balena-io/autohat-board/hardware/main-board/fabrication-files/BOM.xls

 | Bill of Materials (BOM)
Item # | Ref Des | Qty | Manufacturer | Mfg Part # | Description | Package | Type | Your Instructions
1 | U7,U4 | 2 | Texas Instruments | SN74AHC1G14DBVR | IC SCHMITT-TRG INV GATE SOT23-5 | SOT-23-5 | SMD
2 | C25,C5,C24,C26,C1,C7,C10,C11,C13,C14,C15,C16,C17,C18,C20,C22,C6 | 17 | Kemet | C0805C104K5RACTU | CAP CER 0.1UF 50V X7R 0805 | 0805 | SMD
3 | R17,R10,R14,R15,R18,R19,R3,R4,R25,R26 | 10 | Yageo | RC0805JR-0710KL | RES SMD 10K OHM 5% 1/8W 0805 | 0805 | SMD
4 | Q7,Q3,Q4,Q8,Q1,Q2 | 6 | Infineon Technologies | IRF7606TRPBF | MOSFET P-CH 30V 3.6A MICRO8 | Micro8 | SMD
5 | U1 | 1 | Texas Instruments | TS3USB30EDGSR | IC USB SWITCH SGL 1X2 10MSOP | 10-VSSOP | SMD
6 | U8 | 1 | Texas Instruments | TS3A27518EPWR | IC MUX/DEMUX HEX 1X2 24TSSOP | 24-TSSOP | SMD
7 | C2,C21,C23 | 3 | Murata | GRM219R61E106KA12D | CAP CER 10UF 25V X5R 0805 | 0805 | SMD
8 | C8,C9,C28,C29 | 4 | Johanson | 500R15N270KV4T | CAP CER 27PF 50V NP0 0805 | 0805 | SMD
9 | C27 | 1 | Murata | GRM21BR61E475KA12L | CAP CER 4.7UF 25V X5R 0805 | 0805 | SMD
10 | D1,D4 | 2 | Micro Commercial Co | ES1A-LTP | DIODE GEN PURP 50V 1A DO214AC | DO-214AC (SMA) | SMD
11 | FB1 | 1 | Laird-Signal Integrity Products | MI0805K400R-10 | FERRITE BEAD 40 OHM 0805 1LN | 0805 | SMD
12 | R2 | 1 | Vishay Dale | CRCW080590K9FKEA | RES SMD 90.9K OHM 1% 1/8W 0805 | 0805 | SMD
13 | R11,R12,R16,R20,R5,R6,R7,R9 | 8 | Vishay Dale | CRCW08054K70FKEA | RES SMD 4.7K OHM 1% 1/8W 0805 | 0805 | SMD
14 | RL1 | 1 | Omron | G2R-2-DC5 | RELAY GENERAL PURPOSE DPDT 5A 5V | 8POS | thru-hole
15 | U2 | 1 | FTDI | FT245RL-REEL | IC USB TO PARALLEL FIFO 28-SSOP | 28-SSOP | SMD
16 | Q5,Q6 | 2 | Fairchild Semiconductor | 2N7002 | MOSFET N-CH 60V 115MA SOT-23 | SOT-23 (TO-236AB) | SMD
17 | J1 | 1 | Hirose | DM3AT-SF-PEJM5 | CONN MICRO SD CARD PUSH-PUSH R/A | SMD | SMD
18 | P2,P3,P9 | 3 | Wurth Electronics Inc | 614004160211 | CONN USB | 4POS | thru-hole
19 | P6,P7 | 2 | Molex | 70246-0801 | CONN HEADER 8POS .100 VERT GOLD | 8POS | thru-hole
20 | P5,P10 | 2 | CUI Inc. | PJ-002AH | CONN PWR JACK 2.1X5.5MM HIGH CUR | 3POS | thru-hole | Oval drill holes
21 | P8,P1 | 2 | Hirose Connector | ZX62D-B-5P8(30) | CONN RCPT USB MICRO B SMD | SMD | SMD | Oval drill holes
22 | C3 | 1 | Murata | GRM2165C1H102FA01D | CAP CER 1000PF 50V NP0 0805 | 0805 | SMD
23 | C4 | 1 | Murata | GRM216R61E105KA12D | CAP CER 1UF 25V X5R 0805 | 0805 | SMD
24 | C12,C19 | 2 | Kemet | C0805C180J3GACTU | CAP CER 18PF 25V NP0 0805 | 0805 | SMD
25 | FB2,FB3 | 2 | Murata | BLM18PG221SN1D | FERRITE BEAD 220 OHM 0603 1LN | 0603 | SMD
26 | Y1 | 1 | Abracon LLC | ABLS-24.000MHZ-B2-T | CRYSTAL 24.0000MHZ 18PF SMD | HC49/US | SMD
27 | P4 | 1 | Wurth Electronics Inc | 61300611121 | CONN HEADER 6 POS 2.54 | 6POS | thru-hole
28 | R1,R13 | 2 | Vishay Dale | CRCW08051M00FKEA | RES SMD 1M OHM 1% 1/8W 0805 | 0805 | SMD
29 | R8 | 1 | Vishay Dale | CRCW08059K53FKEA | RES SMD 9.53K OHM 1% 1/8W 0805 | 0805 | SMD
30 | U3 | 1 | Texas Instruments | TUSB4041IPAPR | IC USB 2.0 4PORT HUB 64HTQFP | 64-HTQFP | SMD
31 | U5 | 1 | Texas Instruments | TLV73333PDBVR | IC REG LDO 3.3V 0.3A 5SOT23 | SOT-23-5 | SMD
32 | U6 | 1 | Texas Instruments | TLV73311PDBVR | IC REG LDO 1.1V 0.3A 5SOT23 | SOT-23-5 | SMD
33 | R22,R24 | 2 | Vishay Dale | CRCW12100000Z0EA | RES SMD 0.0 OHM JUMPER 1/2W 1210 | 1210 | SMD
34 | R21,R23 | 2 | - | - | - | 2POS | DNS
35 | D2,D3 | 2 | Osram | LG Q396-PS-35 | LED GREEN DIFFUSED 0603 SMD | 0603 | SMD
