balena-io/autohat-board/hardware/inverted-usd-adapter/fabrication-files/BOM.csv

Reference | Quantity | Value | Footprint | Proper Name | Notes
P1 | 1 | CONN_02X04 | PSB_IDC_4x2 | Creatron Inc CONID-106508 | https://www.creatroninc.com/product/8-pin-4x2-idc-shrouded-header/
