balena-io/autohat-board/hardware/main-board/autohat-rig.kicad_pcb

## KiCad design hardware/main-board/autohat-rig.kicad_pcb (2016-12-13)

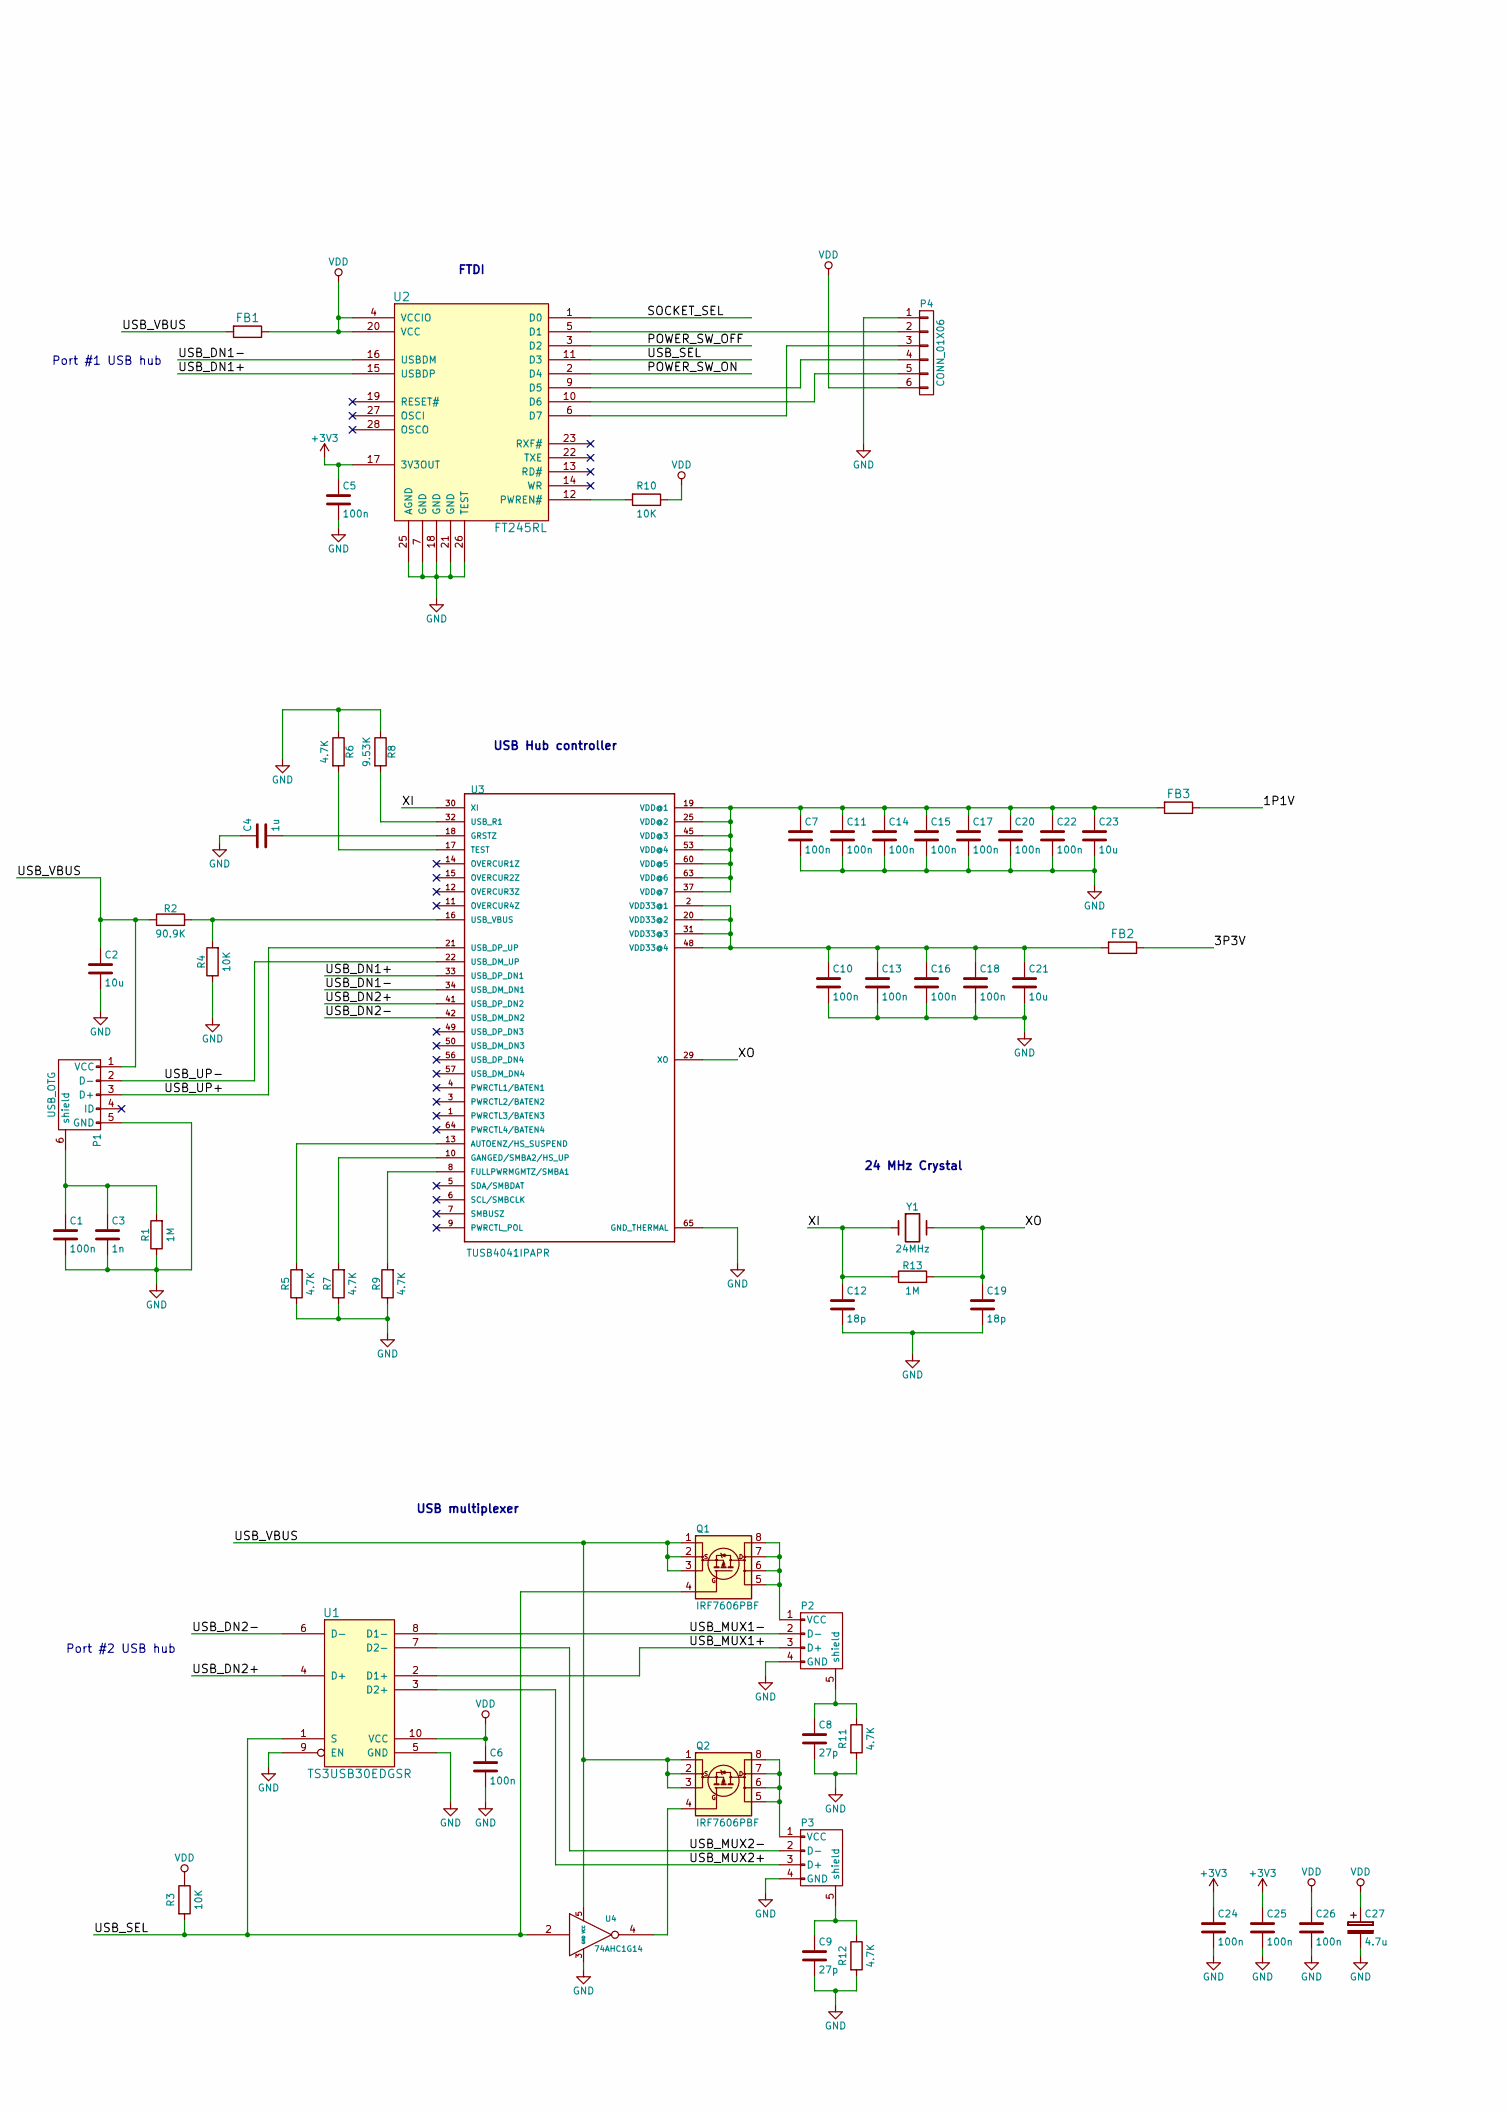
[picture p1: schematic autohat-rig.sch, part in row 1, column 1]

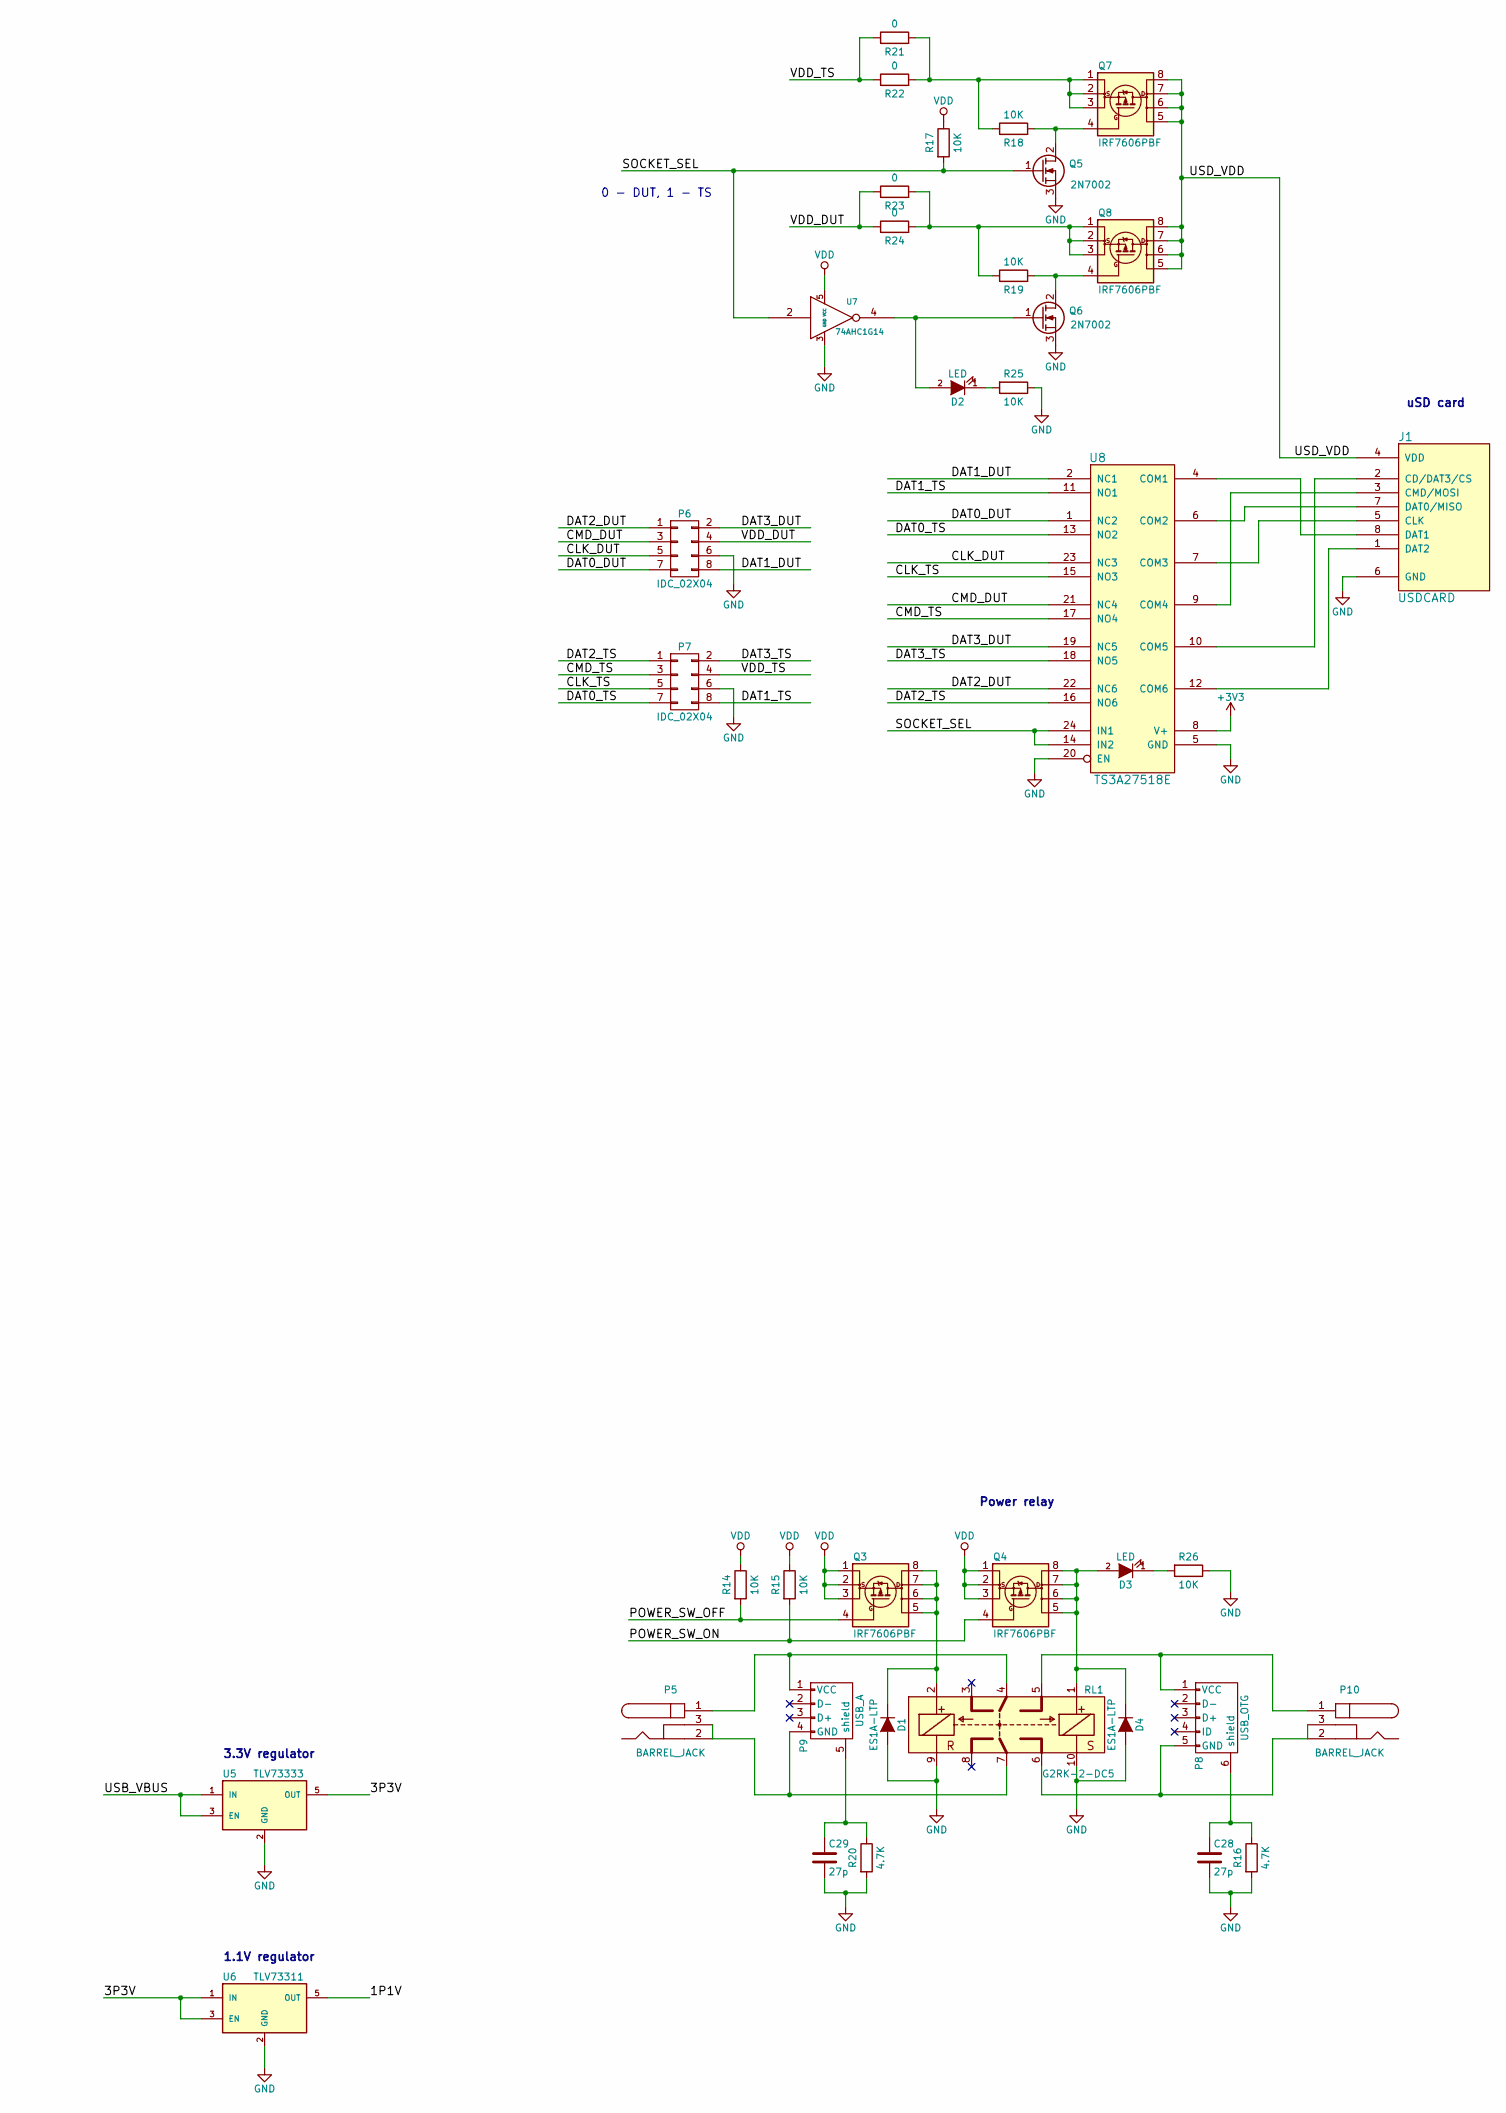
[picture p2: schematic autohat-rig.sch, part in row 1, column 2]

Parts:
C1, C5, C6, C7, C10, C11, C13, C14, C15, C16, C17, C18, C20, C22, C24, C25, C26: 100n; C_0805_HandSoldering
C2, C21, C23: 10u; C_0805_HandSoldering
C3: 1n; C_0805_HandSoldering
C4: 1u; C_0805_HandSoldering
C8, C9, C28, C29: 27p; C_0805_HandSoldering
C12, C19: 18p; C_0805_HandSoldering
C27: 4.7u; C_0805_HandSoldering
D1, D4: ES1A-LTP; SMA_Handsoldering
D2, D3: LED; LED_0603
FB1: MI0805K400R-10; R_0805_HandSoldering
FB2, FB3: BLM18PG221SN1D; R_0603_HandSoldering
J1: USDCARD; HIROSE-MICROSD-DM3AT-SF
P1, P8: USB_OTG; TO_microUSB
P2, P3: 61400416021; conn_usb_A
P4: CONN_01X06; Pin_Header_Straight_1x06
P5, P10: BARREL_JACK
P6, P7: IDC_02X04; PSB_IDC_4x2
P9: USB_A; conn_usb_A
Q1, Q2, Q3, Q4, Q7, Q8: IRF7606PBF; msoic-8
Q5, Q6: 2N7002; SOT-23
R1, R13: 1M; R_0805_HandSoldering
R2: 90.9K; R_0805_HandSoldering
R3, R4, R10, R14, R15, R17, R18, R19, R25, R26: 10K; R_0805_HandSoldering
R5, R6, R7, R9, R11, R12, R16, R20: 4.7K; R_0805_HandSoldering
R8: 9.53K; R_0805_HandSoldering
R21, R23: 0; Resistor_Horizontal_RM10mm
R22, R24: 0; R_1210_HandSoldering
RL1: G2RK-2-DC5; G2RK-2
U1: TS3USB30EDGSR; msoic-10
U2: FT245RL; ssop-28
U3: TUSB4041IPAPR; QFP50P1200X1200X105-65N
U4, U7: 74AHC1G14; SOT-23-5
U5: TLV73333; SOT-23-5
U6: TLV73311; SOT-23-5
U8: TS3A27518E; tssop-24
Y1: 24MHz; Crystal_HC49-SD_SMD

Connections:
+3V3: C5.1, C24.1, C25.1, U2.17 (3V3OUT), U8.8 (V+)
/1P1V: FB3.1, U6.5 (OUT)
/3P3V: FB2.1, U5.5 (OUT), U6.1 (IN), U6.3 (EN)
/CLK_DUT: P6.5, U8.23 (NC3)
/CLK_TS: P7.5, U8.15 (NO3)
/CMD_DUT: P6.3, U8.21 (NC4)
/CMD_TS: P7.3, U8.17 (NO4)
/DAT0_DUT: P6.7, U8.1 (NC2)
/DAT0_TS: P7.7, U8.13 (NO2)
/DAT1_DUT: P6.8, U8.2 (NC1)
/DAT1_TS: P7.8, U8.11 (NO1)
/DAT2_DUT: P6.1, U8.22 (NC6)
/DAT2_TS: P7.1, U8.16 (NO6)
/DAT3_DUT: P6.2, U8.19 (NC5)
/DAT3_TS: P7.2, U8.18 (NO5)
/POWER_SW_OFF: Q3.4 (G), R14.2, U2.3 (D2)
/POWER_SW_ON: Q4.4 (G), R15.2, U2.2 (D4)
/SOCKET_SEL: Q5.1 (G), R17.2, U2.1 (D0), U7.2, U8.14 (IN2), U8.24 (IN1)
/USB_DN1+: U2.15 (USBDP), U3.33 (USB_DP_DN1)
/USB_DN1-: U2.16 (USBDM), U3.34 (USB_DM_DN1)
/USB_DN2+: U1.4 (D+), U3.41 (USB_DP_DN2)
/USB_DN2-: U1.6 (D-), U3.42 (USB_DM_DN2)
/USB_MUX1+: P2.3 (D+), U1.2 (D1+)
/USB_MUX1-: P2.2 (D-), U1.8 (D1-)
/USB_MUX2+: P3.3 (D+), U1.3 (D2+)
/USB_MUX2-: P3.2 (D-), U1.7 (D2-)
/USB_SEL: Q1.4 (G), R3.2, U1.1 (S), U2.11 (D3), U4.2
/USB_UP+: P1.3 (D+), U3.21 (USB_DP_UP)
/USB_UP-: P1.2 (D-), U3.22 (USB_DM_UP)
/USB_VBUS: C2.1, FB1.2, P1.1 (VCC), Q1.1 (S), Q1.2 (S), Q1.3 (S), Q2.1 (S), Q2.2 (S), Q2.3 (S), R2.1, U4.5 (VCC), U5.1 (IN), U5.3 (EN)
/USD_VDD: J1.4 (VDD), Q7.5 (D), Q7.6 (D), Q7.7 (D), Q7.8 (D), Q8.5 (D), Q8.6 (D), Q8.7 (D), Q8.8 (D)
/VDD_DUT: P6.4, R23.1, R24.1
/VDD_TS: P7.4, R21.1, R22.1
/XI: C12.1, R13.1, U3.30 (XI), Y1.1
/XO: C19.1, R13.2, U3.29 (XO), Y1.2
GND: C1.2, C2.2, C3.2, C4.1, C5.2, C6.2, C7.2, C8.2, C9.2, C10.2, C11.2, C12.2, C13.2, C14.2, C15.2, C16.2, C17.2, C18.2, C19.2, C20.2, C21.2, C22.2, C23.2, C24.2, C25.2, C26.2, C27.2, C28.2, C29.2, D1.2 (A), D4.2 (A), J1.6 (GND), P1.5 (GND), P2.4 (GND), P3.4 (GND), P4.1, P6.6, P7.6, Q5.3 (S), Q6.3 (S), R1.1, R4.1, R5.1, R6.1, R7.1, R8.1, R9.1, R11.2, R12.2, R16.2, R20.2, R25.1, R26.1, RL1.9, RL1.10, U1.5 (GND), U1.9 (EN), U2.7 (GND), U2.18 (GND), U2.21 (GND), U2.25 (AGND), U2.26 (TEST), U3.65 (GND_THERMAL), U4.3 (GND), U5.2 (GND), U6.2 (GND), U7.3 (GND), U8.5 (GND), U8.20 (EN)
unnamed: C1.1, C3.1, P1.6 (shield), R1.2
unnamed: C4.2, U3.18 (GRSTZ)
unnamed: C8.1, P2.5 (shield), R11.1
unnamed: C9.1, P3.5 (shield), R12.1
unnamed: C10.1, C13.1, C16.1, C18.1, C21.1, FB2.2, U3.2 (VDD33@1), U3.20 (VDD33@2), U3.31 (VDD33@3), U3.48 (VDD33@4)
unnamed: C7.1, C11.1, C14.1, C15.1, C17.1, C20.1, C22.1, C23.1, FB3.2, U3.19 (VDD@1), U3.25 (VDD@2), U3.37 (VDD@7), U3.45 (VDD@3), U3.53 (VDD@4), U3.60 (VDD@5), U3.63 (VDD@6)
unnamed: C28.1, P8.6 (shield), R16.1
unnamed: C29.1, P9.5 (shield), R20.1
unnamed: D1.1 (K), Q3.5 (D), Q3.6 (D), Q3.7 (D), Q3.8 (D), RL1.2
unnamed: D2.1 (K), R25.2
unnamed: D2.2 (A), Q6.1 (G), U7.4
unnamed: D3.1 (K), R26.2
unnamed: D3.2 (A), D4.1 (K), Q4.5 (D), Q4.6 (D), Q4.7 (D), Q4.8 (D), RL1.1
unnamed: J1.1 (DAT2), U8.12 (COM6)
unnamed: J1.2 (CD/DAT3/CS), U8.10 (COM5)
unnamed: J1.3 (CMD/MOSI), U8.9 (COM4)
unnamed: J1.5 (CLK), U8.7 (COM3)
unnamed: J1.7 (DAT0/MISO), U8.6 (COM2)
unnamed: J1.8 (DAT1), U8.4 (COM1)
unnamed: P2.1 (VCC), Q1.5 (D), Q1.6 (D), Q1.7 (D), Q1.8 (D)
unnamed: P3.1 (VCC), Q2.5 (D), Q2.6 (D), Q2.7 (D), Q2.8 (D)
unnamed: P4.2, U2.5 (D1)
unnamed: P4.3, U2.6 (D7)
unnamed: P4.4, U2.9 (D5)
unnamed: P4.5, U2.10 (D6)
unnamed: P5.1, P9.1 (VCC), RL1.4
unnamed: P5.2, P5.3, P9.4 (GND), RL1.7
unnamed: P8.1 (VCC), P10.1, RL1.5
unnamed: P8.5 (GND), P10.2, P10.3, RL1.6
unnamed: Q2.4 (G), U4.4
unnamed: Q5.2 (D), Q7.4 (G), R18.2
unnamed: Q6.2 (D), Q8.4 (G), R19.2
unnamed: Q7.1 (S), Q7.2 (S), Q7.3 (S), R18.1, R21.2, R22.2
unnamed: Q8.1 (S), Q8.2 (S), Q8.3 (S), R19.1, R23.2, R24.2
unnamed: R2.2, R4.2, U3.16 (USB_VBUS)
unnamed: R5.2, U3.13 (AUTOENZ/HS_SUSPEND)
unnamed: R6.2, U3.17 (TEST)
unnamed: R7.2, U3.10 (GANGED/SMBA2/HS_UP)
unnamed: R8.2, U3.32 (USB_R1)
unnamed: R9.2, U3.8 (FULLPWRMGMTZ/SMBA1)
unnamed: R10.2, U2.12 (PWREN#)
VDD: C6.1, C26.1, C27.1, FB1.1, P4.6, Q3.1 (S), Q3.2 (S), Q3.3 (S), Q4.1 (S), Q4.2 (S), Q4.3 (S), R3.1, R10.1, R14.1, R15.1, R17.1, U1.10 (VCC), U2.4 (VCCIO), U2.20 (VCC), U7.5 (VCC)

Notes on the sheet:
0 - DUT, 1 - TS
24 MHz Crystal
USB Hub controller
FTDI
uSD card
Power relay
USB multiplexer
Port #1 USB hub
Port #2 USB hub
3.3V regulator
1.1V regulator

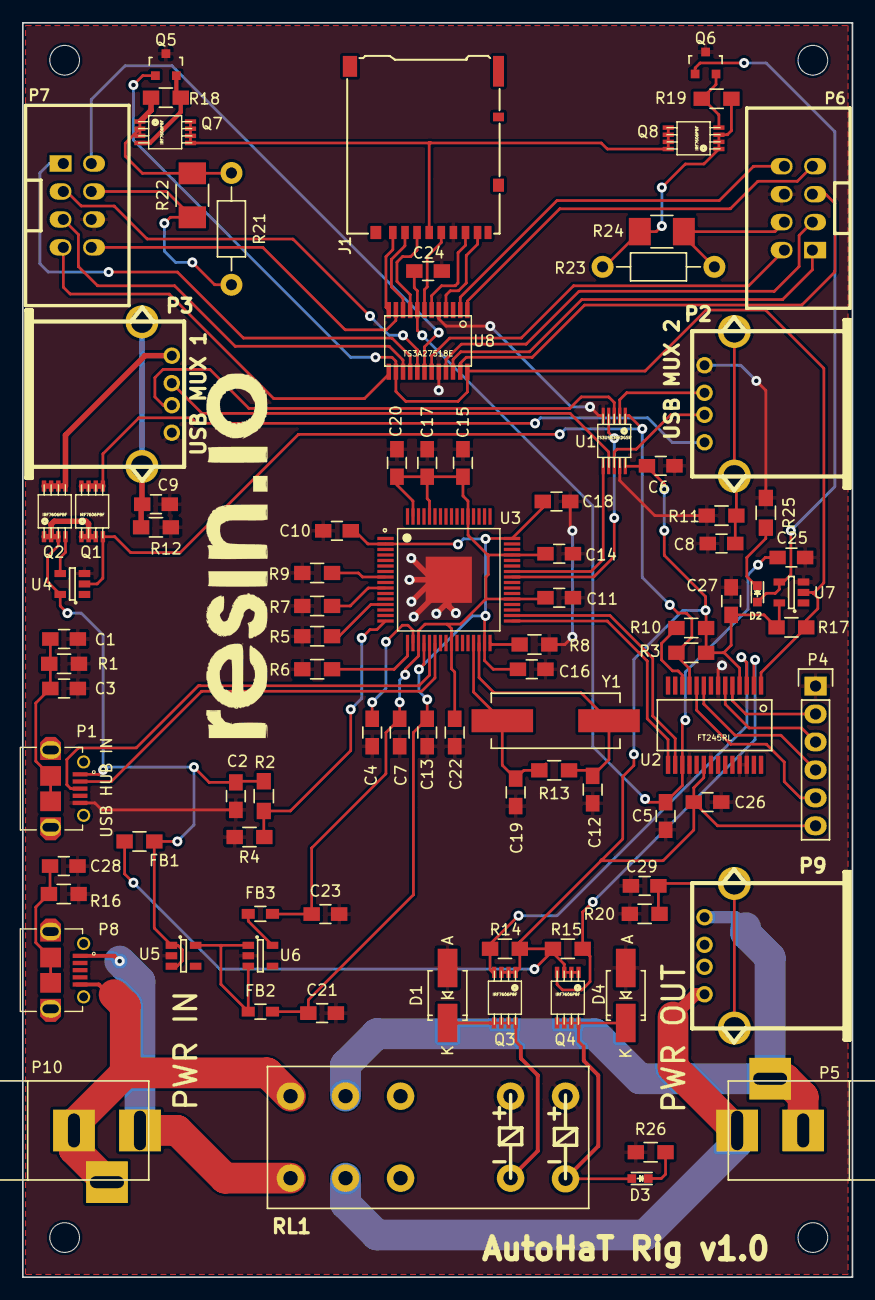
[picture p3: board autohat-rig.kicad_pcb from above]

Board: 2 copper layers, 75.4 x 114.0 mm, 91 parts (0 on the bottom side), 78 nets.
