balena-io/autohat-board/(commit log)

2016-04-01 Add sd-mux hardware documentation
    [sd-mux.kicad_pcb, sd-mux.sch]
2016-04-26 Add MicroSD card adapter hardware documentation
    [sd-mux.kicad_pcb, sd-mux.sch, usd-adapter.kicad_pcb, usd-adapter.sch]
2016-05-05 Add command for getting current state of device
2016-06-18 Fix connectors and increase board size on usd-adapter
    [usd-adapter.kicad_pcb, usd-adapter.sch]
2016-06-20 Change via's shape to oval and check manufacturer requirements
    [usd-adapter.kicad_pcb, usd-adapter.sch]
2016-06-27 Fix SD card slot, remove SD card power leakage and add power connectors
    [sd-mux.kicad_pcb, sd-mux.sch]
2016-07-08 Add USB hub to schematic
    [sd-mux.kicad_pcb, sd-mux.sch]
2016-07-09 Add USB hub to the layout
    [sd-mux.kicad_pcb, sd-mux.sch]
2016-07-12 Add thermal vias and check USB layout guidelines
    [sd-mux.kicad_pcb]
2016-07-13 Add BOM and Gerber files
    [BOM.csv, sd-mux.kicad_pcb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]
2016-07-19 Add missing decoupling capacitor and update fabrication files
    [BOM.csv, sd-mux.kicad_pcb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]
2016-07-19 Add missing libraries and unpopulated headers to BOM
    [BOM.csv]
2016-07-19 Add BOM and Gerber files for uSD adapter
    [BOM.csv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]
2016-07-21 Fix the part number of conn_usb_B_micro mangled by the csv conversion
    [BOM.csv]
2016-07-21 Fix IDC connector on usd-adapter and add inverted version of it
    [BOM.csv, inverted-usd-adapter.kicad_pcb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]
2016-08-22 Add missing parts to BOM
    [BOM.csv]
2016-08-22 Fix crystal on layout
    [sd-mux.kicad_pcb, sd-mux.sch]
2016-08-23 Change crystal, swap USB power I/O and wider power tracks to withstand 5A
    [BOM.csv, sd-mux.kicad_pcb, sd-mux.sch]
2016-09-19 Improve spacing on power tracks
    [sd-mux.kicad_pcb]
2016-09-20 Replace diodes with 0 ohm resistors and testing holes for measuring current leakage
    [BOM.csv, sd-mux.kicad_pcb, sd-mux.sch]
2016-09-21 Adapt FTDI's GPIO header to match Adafruit's level shifter
    [BOM.csv, sd-mux.kicad_pcb, sd-mux.sch]
2016-09-23 Add status LEDs
    [BOM.csv, sd-mux.kicad_pcb, sd-mux.sch]
2016-10-05 Repo cleanup
    [BOM.csv, inverted-usd-adapter.kicad_pcb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]
2016-10-08 Update BOM and layout labels
    [BOM.csv, BOM.xlsx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]
2016-10-18 Add fabrication files for second iteration
    [BOM.xls, BOM.xlsx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]
2016-12-12 Add mounting holes and labels
    [autohat-rig.kicad_pcb]
2016-12-12 Change micro USB socket to through-hole
    [BOM.xls, autohat-rig.kicad_pcb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]
2016-12-13 Fix BOM and outdated library dependency
    [BOM.xls]
