balena-io/autohat-board/(notices)

Notices in the files:
hardware/inverted-usd-adapter/inverted-usd-adapter.kicad_pcb:
Copyright (c) 2016 Samsung Electronics Co., Ltd All Rights Reserved
